yallport/sdc-EOgmaNeo/rustler_mount.stl

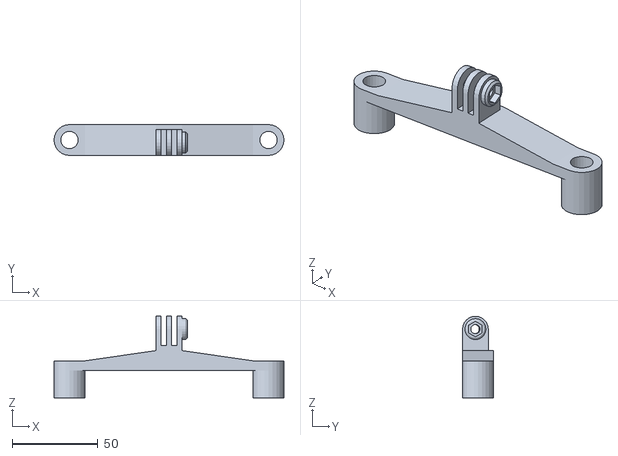
[picture p5: CAD file, 2018-06-01]
rustler_mount.stl
134.0 x 18.0 x 47.5
