yallport/sdc-EOgmaNeo/self-driving car/pi_sdc.py

import cv2
import eogmaneo
import os
import os.path
import picamera
import pygame
import pygame.joystick
import pygame.surface
import re
import serial
import signal
import struct
import sys
import time
import numpy as np
from PIL import Image
from threading import Thread
from threading import Lock
from threading import Condition
from threading import Barrier



trimming = 0.1

# Runs code without creating a pygame window
os.environ["SDL_VIDEODRIVER"] = "dummy"


def pygame_to_pil_img(pg_surface):
    imgstr = pygame.image.tostring(pg_surface, 'RGB')
    return Image.fromstring('RGB', pg_surface.get_size(), imgstr)


def pil_to_pygame_img(pil_img):
    imgstr = pil_img.tostring()
    return pygame.image.fromstring(imgstr, pil_img.size, 'RGB')


def matToVec(mat):
    return mat.flatten().astype(np.float32).tolist()


def sigmoid(x):
    return 1.0 / (1.0 + np.exp(-x))


endProg = False

signal.signal(signal.SIGINT, signal.default_int_handler)

camWidth = 64
camHeight = 64

steerChunkSize = int(6)
lineChunkSize = int(6)
lineSDRSizeDiv = int(1)

lineStepSize = lineChunkSize * 0.666
minLineLength = 6

pygame.init()
pygame.joystick.init()
joystick_count = pygame.joystick.get_count()


if joystick_count < 1:
    print("No joysticks found.")
    time.sleep(1)
    sys.exit()

print("Found " + str(joystick_count) + " joysticks.")

joy = pygame.joystick.Joystick(0)
joy.init()

camera = picamera.PiCamera()

camera.resolution = (camWidth, camHeight)
camera.framerate = 24

# camera.start_preview()

time.sleep(2)

######################

ser = serial.Serial('/dev/ttyACM0', 115200)

esystem = eogmaneo.ComputeSystem(4)

ld = 6 * [ eogmaneo.LayerDesc() ]

for l in range(0, len(ld)):
    ld[l]._width = 36
    ld[l]._height = 36
    ld[l]._chunkSize = 6

    if l == 0:
        ld[l]._forwardRadius = 9
        ld[l]._backwardRadius = 9
    else:
        ld[l]._forwardRadius = 9
        ld[l]._backwardRadius = 9
        
    ld[l]._ticksPerUpdate = 2
    ld[l]._temporalHorizon = 2
    ld[l]._alpha = 0.1
    ld[l]._beta = 0.1
    ld[l]._gamma = 0.01

hiddenWidth = camWidth
hiddenHeight = int(camHeight / 2)

h = eogmaneo.Hierarchy()
h.create([ ( hiddenWidth, hiddenHeight ), ( steerChunkSize, steerChunkSize ) ], [ lineChunkSize, steerChunkSize ], [ False, True ], ld, 41)

sdrWidth = int(hiddenWidth / lineSDRSizeDiv)
sdrHeight = int(hiddenHeight / lineSDRSizeDiv)

numChunksInX = int(sdrWidth / lineChunkSize)
numChunksInY = int(sdrHeight / lineChunkSize)
numChunks = numChunksInX * numChunksInY
bitsPerChunk = lineChunkSize * lineChunkSize

lsd = cv2.createLineSegmentDetector(0)

trainMode = True
enabled = False

targetSteer = 0.0
targetDrive = 0.0
targetMode = False

speedMul = 0.25
capTime = 5.0
capTimer = 0.0
imgIndex = 0

steer = 0
drive = 0
mode = 0

joymodePrev = False

while not endProg:
    try:
        timeStart = pygame.time.get_ticks()
        
        for event in pygame.event.get():
            if event.type == pygame.QUIT:
                endProg = True

        keys = pygame.key.get_pressed()

        if keys[pygame.K_ESCAPE]:
            endProg = True

        ############################

        # Receive data
        joydrive = (joy.get_axis(5) * 0.5 + 0.5) - (joy.get_axis(2) * 0.5 + 0.5)
        joysteer = joy.get_axis(0)

        joymode = joy.get_button(0)

        steer = joysteer
        drive = joydrive * speedMul

        if joymode and not joymodePrev:
            mode = not mode

        joymodePrev = joymode

        moving = drive > 0.036

        training = not mode
        
        ############################

        visData = np.empty((camHeight, camWidth, 3), dtype=np.uint8)

        camera.capture(visData, "rgb", use_video_port=True)

        visData = visData[0:int(hiddenHeight), :, :]   
        
        visDataGrey = 0.333 * ((visData[:,:,0].T / 255.0) + (visData[:,:,1].T / 255.0) + (visData[:,:,2].T / 255.0))

        visDataGrey = visDataGrey.reshape((hiddenHeight, hiddenWidth))
        visDataGreyb = (visDataGrey * 255).astype(np.uint8)
        
        lines = lsd.detect(visDataGreyb)

        rotSDR = numChunks*[int(0)]

        chunkResponses = numChunks*[-99999.0]

        # Assign lines to SDR
        if lines[0] != None:
            for l in lines[0]:
                bpt = l[0][0:2]
                ept = l[0][2:4]

                delta = ept - bpt

                mag = np.sqrt(delta[0] * delta[0] + delta[1] * delta[1])

                if mag < minLineLength:
                    continue

                response = mag

                delta = lineStepSize * delta / np.maximum(0.0001, mag)

                angle = np.arctan2(delta[1], delta[0])

                steps = int(mag / lineStepSize)

                p = bpt

                for s in range(steps):
                    # Fill
                    cx = min(numChunksInX - 1, max(0, int(p[0] / lineSDRSizeDiv / lineChunkSize)))
                    cy = min(numChunksInY - 1, max(0, int(p[1] / lineSDRSizeDiv / lineChunkSize)))

                    chunkIndex = cx + cy * numChunksInX

                    if response > chunkResponses[chunkIndex]:
                        chunkResponses[chunkIndex] = response

                        rotSDR[chunkIndex] = int(angle / (np.pi * 2.0) * (bitsPerChunk - 1)) % bitsPerChunk

                        if rotSDR[chunkIndex] < 0:
                            rotSDR[chunkIndex] += bitsPerChunk

                    # Step
                    p += delta

        if capTimer >= capTime:
            capTimer = 0.0

            #cv2.imwrite("imgs/img" + str(int(imgIndex)) + ".png", visData[:,:,::-1])

            imgIndex += 1

        useSteerSDR = [ int((steer * 0.5 + 0.5) * (steerChunkSize * steerChunkSize - 1) + 0.5) ]

        if not training:
            useSteerSDR = h.getPredictions(1)

        #print(rotSDR)
     
        h.step([ rotSDR, useSteerSDR ], esystem, training and moving)

        sendSteer = steer
        sendDrive = drive

        if not training:
            predSteerIndex = h.getPredictions(1)[0]
                
            sendSteer = min(1.0, max(-1.0, predSteerIndex / float(steerChunkSize * steerChunkSize - 1) * 2.0 - 1.0))

            sendDrive = 0.164

        trimmedSteer = min(1.0, max(-1.0, sendSteer + trimming))

        ser.write(bytes([int((trimmedSteer * 0.5 + 0.5) * 255), int((sendDrive * 0.5 + 0.5) * 255)]))

        ############################

        timeEnd = pygame.time.get_ticks()

        deltaTime = timeEnd - timeStart

        if training and moving:
            capTimer += deltaTime * 0.001

        pygame.time.delay(max(0, 50 - deltaTime))
        
    except KeyboardInterrupt:
        endProg = True
        break

pygame.quit()
ser.close()



# ----------------------------------------------------------------------------
#
#  EOgmaDrive
#  Copyright(c) 2017 Ogma Intelligent Systems Corp. All rights reserved.
#
#  This copy of EOgmaDrive is licensed to you under the terms described
#  in the EOGMADRIVE_LICENSE.md file included in this distribution.
# ----------------------------------------------------------------------------

# -*- coding: utf-8 -*-
