yallport/sdc-EOgmaNeo/(commit log)

2018-06-01 Add mount stl
    [rustler_mount.stl]
2018-06-03 Add steering and driving servos
